ZeniteSolar/MAM17/README.md

# Modulo do Acionamento do Motor 2017
Versão do acionamento de um motor de ímã permanente da embarcação Guarapuvu II (Zênite Solar) para o DSB 2017.
