ZeniteSolar/MAM17/(list of files, drawings)

Other design files:
hardware/atmega.SchDoc
hardware/chopper.SchDoc
hardware/driver.SchDoc
hardware/MAM17.PcbDoc
hardware/MAM17.PrjPCB
hardware/MAM17_chopper.PcbDoc
hardware/MAM17_driver_correction.PcbDoc
