ZeniteSolar/MAM17/firmware/src/adc.c

#include "adc.h"

uint8_t raw_adc[ADC_LAST_CHANNEL]; //*< an array for raw measurements
volatile cbuf0_t cbuf_adc0;
uint8_t avg_adc0;

/**
 * @brief initializes all adc circular buffers.
 */
void init_buffers(void)
{
    CBUF_Init(cbuf_adc0);
}

/**
 * @brief computes the average of a given adc channel
 *
 * Ma = (1/N)*Summation of x[i] from i=0 to N, 
 * if N = 2^k, then Ma = (Summation of x[i] from i=0 to N) >> k
 *
 */
uint8_t ma_adc0(void)
{   
    uint16_t sum = 0;
    for(uint8_t i = cbuf_adc0_SIZE; i; i--){
        sum += CBUF_Get(cbuf_adc0, i);
    }
    // Here it is matematically safe to expect sum to fit into uint8_t only because
    // cbuf_adc0_SIZE and cbuf_adc0_SIZE_2 are coherently defined.
    avg_adc0 = (uint8_t) (sum >> cbuf_adc0_SIZE_2);
    return avg_adc0;
}

/**
 * @brief Muda o canal do adc
 */
void adc_select_channel(adc_channels_t __ch)
{
    ADC_CHANNEL = __ch;
    #pragma GCC diagnostic ignored "-Wconversion"
        ADMUX =(ADMUX & 0xF8) | ADC_CHANNEL; // clears the bottom 3 bits before ORing
    #pragma GCC diagnostic pop
}

/**
 * @brief inicializa o ADC, configurado para conversão engatilhada com o timer0.
 */
void adc_init(void)
{
    // configuracao do ADC
    PORTC   =   0b00000000;                         // pull-up for adcs
    DDRC    =   0b00000000;                         // all adcs as inputs
    DIDR0   =   0b11111111;                         // All ADC Pin is disabled for digital use.

    ADMUX   =   (0 << REFS1)                        // AVcc with external capacitor at AREF pin
            | (1 << REFS0)
            | (1 << ADLAR);                         // ADC left adjusted -> using 8bits ADCH only

    ADCSRB  =   (0 << ADTS2)                        // Auto-trigger source: timer0 Compare Match A
            | (1 << ADTS1)
            | (1 << ADTS0);

    adc_select_channel(ADC1);                       // Choose admux
    ADCSRA  =   (1 << ADATE)                        // ADC Auto Trigger Enable
            | (1 << ADIE)                           // ADC Interrupt Enable
            | (1 << ADEN)                           // ADC Enable
            | (1 << ADSC)                           // Do the first Start of Conversion
            | (1 << ADPS2)                          // ADC Prescaller = 128;
            | (1 << ADPS1)
            | (1 << ADPS0);


    // configuracao do Timer TC0 --> TIMER DO ADC
    TCCR0A  =   (1 << WGM01) | (0 << WGM00)         // Timer 0 in Mode 2 = CTC (clear on compare)
            | (0 << COM0A1) | (1 << COM0A0)         // Toggle OC0A on Compare Match
            | (0 << COM0B1) | (0 << COM0B0);        // do nothing with OC0B
    TCCR0B  =   (0 << WGM02)                        // Timer 0 in Mode 2 = CTC (clear on compare)
            | (0 << FOC0A) | (0 << FOC0B)           // dont force outputs
            | (1 << CS02)                           // clock enabled, prescaller = 256
            | (0 << CS01)
            | (0 << CS00);

	OCR0A  =    207;                                    // Valor para igualdade de comparacao A para frequencia de 150 Hz
    TIMSK0 |=   (1 << OCIE0A);                        // Ativa a interrupcao na igualdade de comparação do TC0 com OCR0A

}

/**
 * @brief MUX do ADC
 */
ISR(ADC_vect){
    //raw_adc[ADC_CHANNEL] = ADCH;                  // utilizando o raw
    CBUF_Push(cbuf_adc0, ADCH);                     // utilizando a media

    //VERBOSE_MSG(usart_send_char(ADC_CHANNEL));   
    
    // TODO: TESTAR O MUX:
    //if(++ADC_CHANNEL > ADC_LAST_CHANNEL) ADC_CHANNEL = ADC0;
}
 
/**
 * @brief ISR necessária para auto-trigger do ADC. Caso contrário, dispara
 * BADISR_vect.
 */
EMPTY_INTERRUPT(TIMER0_COMPA_vect);
