ZeniteSolar/MAM17/(commit log)

2017-10-11 Primeira versão estável de 2017. Ainda utilizando o hardware de 2016. Esta versão inicial contém: -leitura adc do potenciometro -leitura io do deadman' switch -leitura io do on/off switch -leitura io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
2017-10-14 avr-can-lib configurada como um submódulo. Nota: agora deve ser executado makelib.sh antes de up.sh, pois a avr-can-lib precisa ser compilada antes do projeto.
2017-10-15 Documentação removida para manutençãe.
2017-10-22 PWM functions restructured. Now fault counter resets if no ocurrence. All functions about pwm moved to machine module. Pwm calc_d was splitted in three other funtions. Fault counter resets if there i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
    [conf.h, machine.c, machine.h, main.c]
2017-10-22 Added IDS for MIC17 and assigned to receive MIC17 STATE and MOTOR msgs.
2017-10-22 Basic canbus application for AC17 is now structured.
2017-10-25 Verboses adicionados, trocada a ordem de inicialização. Nota: o PWM precisa ser iniciado após o CAN por alguma incompatibilidade... É necessário testar para ver se não há danos no funcionament do can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
    [can_app.c, conf.h, machine.c, main.c]
2017-10-27 .h guards renamed, pwm moved to its own module, pwm conflict with chip-select of mcp2515 solved. MCP2515 tx/rx errors is sown (verbose only)
    [adc.h, can_app.c, can_app.h, can_filters.h, conf.h, machine.c, machine.h]
2017-10-27 Minor fixes to compile
    [conf.h]
2017-10-27 Can filters moved to its own file.
2017-10-27 Minor changes in order to fix modularizaton.
    [adc.h, can_app.c, can_app.h, conf.h]
2017-10-27 Added another level of verbose. Machine now is running in a fixed clock.
    [conf.h, machine.c, machine.h, main.c]
2017-10-29 Added detection of no messages received from mic17 as an error trigger
    [can_app.c, can_app.h]
2017-10-29 Fixed some verbose messages.
    [main.c]
2017-10-29 pwm_reset enabled
2017-10-30 pwm headers added
2017-10-30 verbose messages added and pwm_zero_width fixed.
    [pwm.c, pwm.h]
2017-11-03 added gitignore for altium and hardware files (altium)
    [AC17.PrjPCB, PCB.PcbDoc, atmega.SchDoc, driver.SchDoc, panel_print.PcbDoc, supplies.SchDoc]
2017-11-07 PWM arrumado.
2017-12-06 severalconfigs in PWM part to make it work as required
2018-05-26 Last changes of 2017 version.
    [MAM17.PcbDoc, MAM17.PrjPCB, MAM17_chopper.PcbDoc, MAM17_driver_correction.PcbDoc, PCB.PcbDoc, atmega.SchDoc, chopper.SchDoc, driver.SchDoc]
2022-02-25 Fix rtr flags in old can messages
    [can_app.c]
2022-02-25 Use extern modifier to fix duplicated variables being defined on newer GCC
    [adc.c, adc.h, can_app.c, can_app.h, machine.c, machine.h, pwm.c, pwm.h]
2022-02-25 Fix missing-prototypes
2022-02-26 Fix the majority of conversion warnings.
    [adc.c, can_app.c, conf.h, machine.c, pwm.c, sleep.h, usart.c]
2024-07-25 Add extractor for Contactor messages, and error checking.
    [can_app.c, can_app.h, machine.h]
2024-07-25 Use pwm_reset() instead of turn_pwm_off().
2024-07-25 Use state msgs to reset can error counter
    [can_app.c]
2024-07-25 FIX: machine state, can filters -is working-
    [can_filters.h, machine.c]
2024-07-25 Make the motor waiting time proportinal to last duty cycle value.
2024-07-25 src: Fix CAN Motor message
    [can_app.c]
